fraserw/endorphin-parallelbelts/STLs/stage-1/x-tensioner-dual-pulley.stl

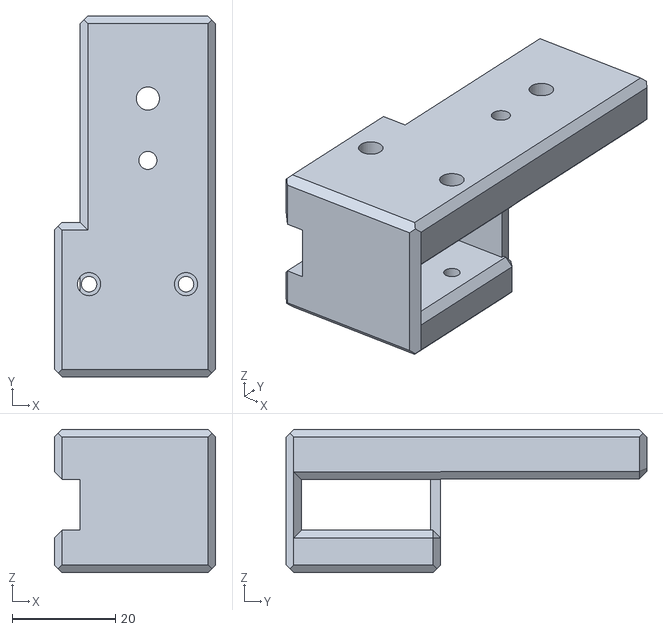
[picture p1: CAD file, 2026-07-17]
STLs/stage-1/x-tensioner-dual-pulley.stl
31.3 x 70.0 x 27.8
