fraserw/endorphin-parallelbelts/(commit log)

2026-07-17 add tensioner stl
    Upload v0 of the dual-pulley x-tensioner
    [x-tensioner-dual-pulley.stl]
2026-07-17 Update stage-1.md to include dual pulley x-tensioner
